nyinyinyanlin/OpenDispenser/hardware/OpenDispenser_Schematic.png

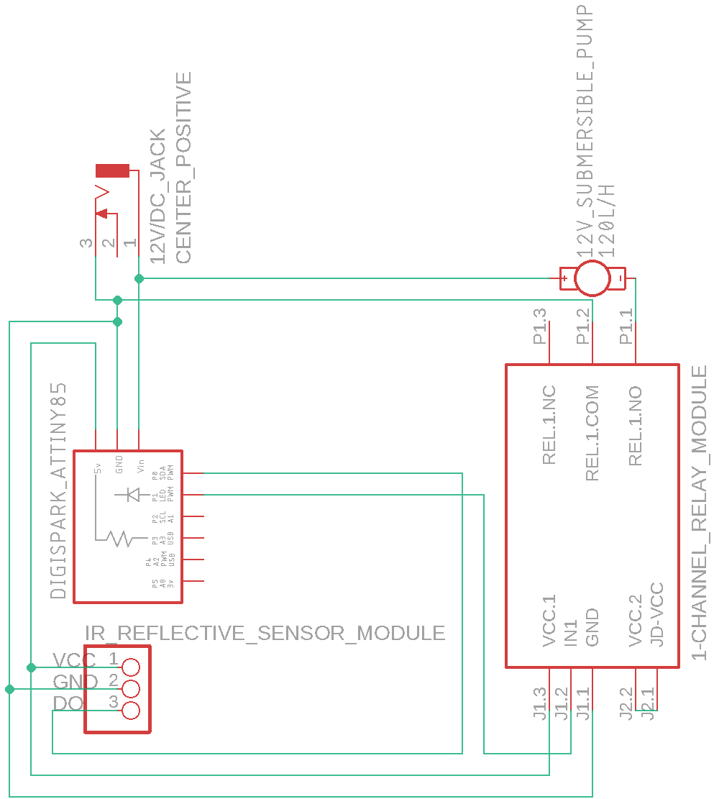
hardware/OpenDispenser_Schematic.png
