nyinyinyanlin/OpenDispenser/images/12v_dc_adapter.jpg

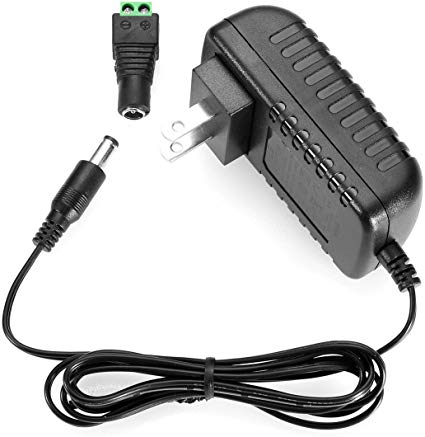
images/12v_dc_adapter.jpg
