nyinyinyanlin/OpenDispenser/images/team_work.jpg

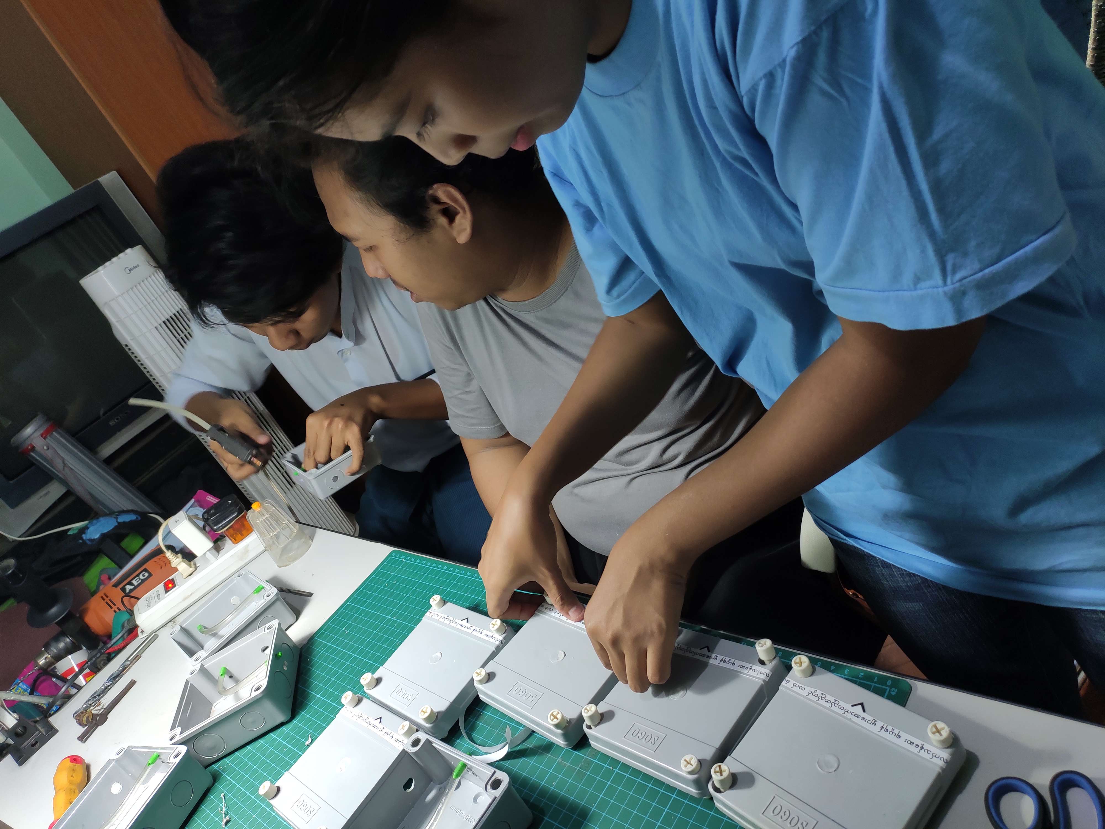
images/team_work.jpg
