nyinyinyanlin/OpenDispenser/images/team_work_2.jpg

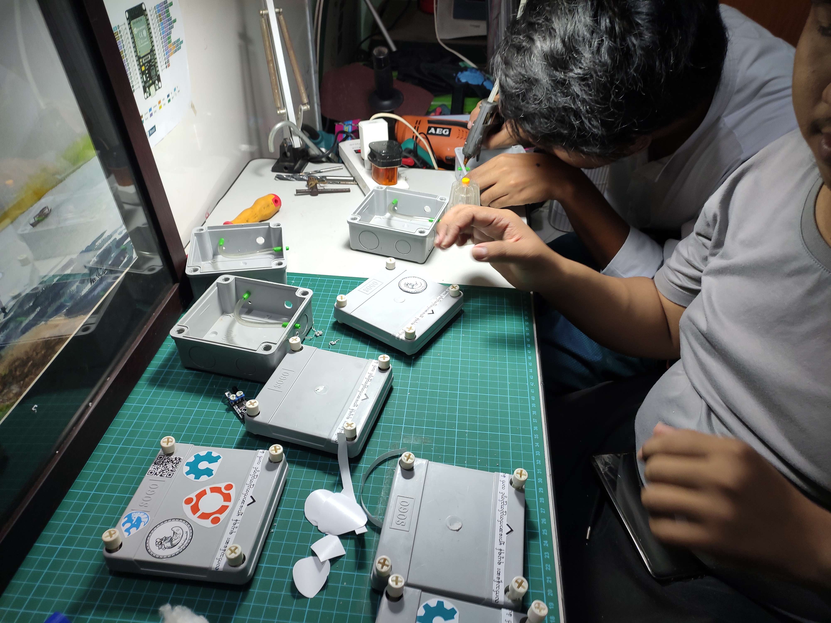
images/team_work_2.jpg
