nyinyinyanlin/OpenDispenser/(commit log)

2020-02-13 Logo directory for sticker printing added
2020-02-17 Basic Arduino code for ATtiny85 MCU
2020-02-17 Wiring/schematic diagram for the whole setup.
2020-02-18 Inserted images
